LyRIng/CL2bm1/examples/cvavrexamples/lcdserialanalog/drivers/uart1a/doc/images/20180131_003055.jpg

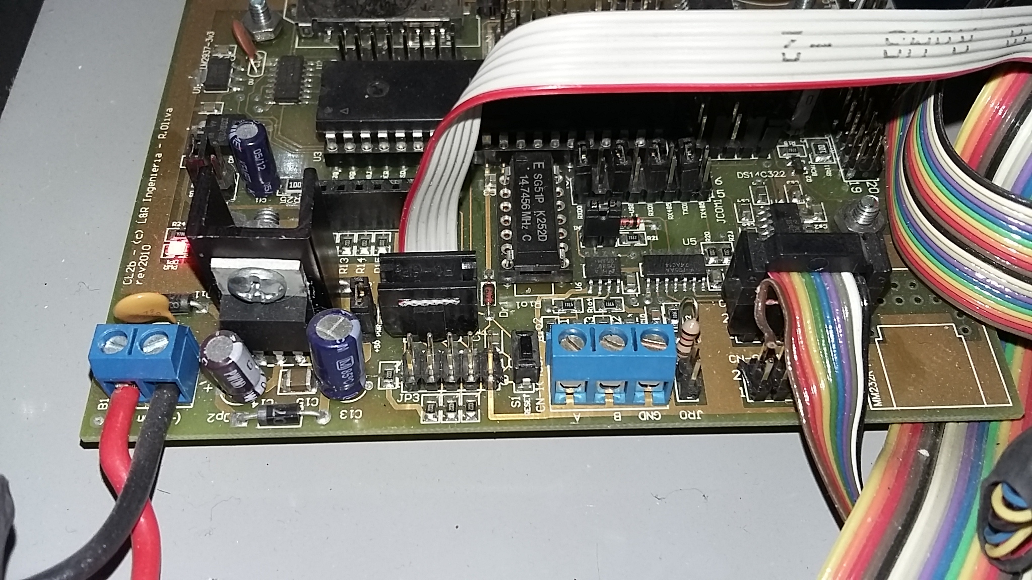
examples/cvavrexamples/lcdserialanalog/drivers/uart1a/doc/images/20180131_003055.jpg
