LyRIng/CL2bm1/examples/cvavrexamples/lcdserialanalog/drivers/uart1a/doc/Printed/Uart1_dr1_h.pdf

File: C:\cvavr328\Work3\CL2\CL2_Drivers\UART1A\TST_MENU_PRJ\inc\Uart1_dr1.h, Date: 22/02/2018, Time: 1

- 1 -

1 /***************************** C HEADER FILE *********************************
2 **
3 | ** | Project: | UART1 Driver for CL2bm1 (UART1A)
4 | ** | Filename: | Uart1_dr1.h
5 | ** | Date: | 21.02.2018
6 **
7 | ** | Modified | R.Oliva | - Include interrupt routines in C separate file (test)
8 | ** | UART1A with selectable BaudRate INIT
9 **
10 ******************************************************************************
11 **
12 **
13 ******************************************************************************
14 **
15 | ** | VERSION HISTORY:
16 | ** | ----------------
17 | ** | initial Version: | 1.0
18 | ** | Date: | 21.02.2018
19 | ** | Revised by: R.Oliva
20 | ** | Description:
21 | ** | -
22 | ** | - Newer versions see top.
23 **
24 **
25 **
26 *****************************************************************************/
27
28 #ifndef UART1_INCLUDED
29 #define UART1_INCLUDED
30
31 /****************************************************************************
32 **
33 | ** | MODULES USED
34 **
35 ****************************************************************************/ 36 #include <stdio.h>
37
38 /****************************************************************************
39 **
40 | ** | DEFINITIONS AND MACROS
41 **
42 ****************************************************************************/
43
44 #ifndef RXB8
45 #define RXB8 1
46 #endif
47
48 #ifndef TXB8
49 #define TXB8 0
50 #endif
51
52 #ifndef UPE
53 #define UPE 2
54 #endif
55
56 #ifndef DOR
57 #define DOR 3
58 #endif
59
60 #ifndef FE
61 #define FE 4
62 #endif
63
64 #ifndef UDRE
65 #define UDRE 5
66 #endif
67
68 #ifndef RXC
69 #define RXC 7
70 #endif
71
72 #ifndef FRAMING_ERROR
73 #define FRAMING_ERROR (1<<FE) 74 #endif
75
76 #ifndef PARITY_ERROR
77 #define PARITY_ERROR (1<<UPE)

- 2 -

78 #endif
79
80 #ifndef DATA_OVERRUN
81 #define DATA_OVERRUN (1<<DOR) 82 #endif
83
84 #ifndef DATA_REGISTER_EMPTY
85 #define DATA_REGISTER_EMPTY (1<<UDRE) 86 #endif
87
88 #ifndef RX_COMPLETE
89 #define RX_COMPLETE (1<<RXC) 90 #endif
91
92 // USART1 Receiver buffer
93 // New Value 22.3.2012 - works at 38400baud 94 // #define RX_BUFFER_SIZE1 8
95 #define RX_BUFFER_SIZE1 96
96
97 // USART1 Transmitter buffer 98 // 22.3.2012 New Value
99 // #define TX_BUFFER_SIZE1 8
100 #define TX_BUFFER_SIZE1 24
101
102 // UART1A - Init Baud Rate param 21.2.2018
103 | #define PBAUD_9600 | 0
104 #define PBAUD_19200 1
105 #define PBAUD_38400 2
106
107
108
109 /****************************************************************************
110 **
111 | ** | EXPORTED VARIABLES
112 | ** | declared here, but defined in .c file for global access.. 30.01.2018
113 **
114 ****************************************************************************/
115
116 extern char rx_buffer1[RX_BUFFER_SIZE1];
117
118
119 #if RX_BUFFER_SIZE1 <= 256
120 extern unsigned char rx_wr_index1,rx_rd_index1,rx_counter1; 121 #else
122 extern unsigned int rx_wr_index1,rx_rd_index1,rx_counter1; 123 #endif
124
125 // This flag is set on USART1 Receiver buffer overflow 126 extern bit rx_buffer_overflow1;
127
128 extern char tx_buffer1[TX_BUFFER_SIZE1];
129
130 #if TX_BUFFER_SIZE1 <= 256
131 extern unsigned char tx_wr_index1,tx_rd_index1,tx_counter1; 132 #else
133 extern unsigned int tx_wr_index1,tx_rd_index1,tx_counter1;
134 #endif
135
136 /****************************************************************************
137 **
138 | ** | EXPORTED FUNCTIONS
139 | ** | functions public to rest of program 30.01.2018
140 **
141 ****************************************************************************/
142
143 // Interrupt routines
144 interrupt [USART1_RXC] void usart1_rx_isr(void);
145 interrupt [USART1_TXC] void usart1_tx_isr(void);
146
147 // Alternate getchar1() defined with ISR Rx support 148 char getchar1(void);
149
150 // Alternate putchar1() defined with ISR Tx support
151 void putchar1(char c);
152
153 // USART1_Init modified (UART1A) for pbaud parameter 21.2.18 154 void USART1_Init(unsigned char pbaud);

- 3 -

155
156 #endif
157 /****************************************************************************
158 **
159 | ** | EOF
160 **
161 ****************************************************************************/
162
