LyRIng/CL2bm1/examples/cvavrexamples/lcdserialanalog/drivers/uart1a/doc/UART1A_DR1_CONSTR+TESTING FOR HEADER RULES COMPLIANCE_v21-02-2018.pdf

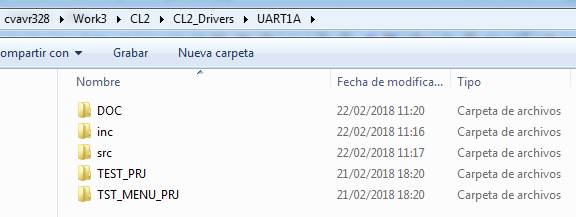
[picture p85: figure]
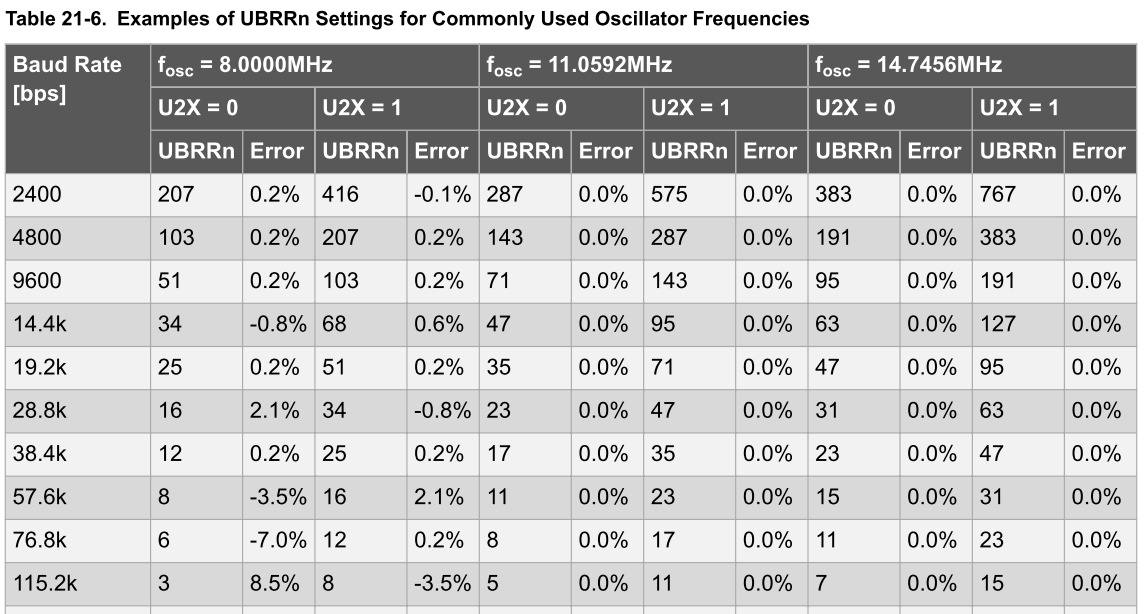
[picture p86: figure]

UART1A/ UART1_DR1 – Module CL2 / Construction + Header rules compliance testing – 20.02.2018 | Página 1

## CONSTRUCTION AND TESTING FOR HEADER RULES COMPLIANCE (Kieras, 2012)

## UART1A/UART1_DR1 MODULE on CVAVR 3 / CL2 – Rev. 21-02-2018 / R.Oliva

(UART1A / Variable Init Baud Rate, to use 4DSys Displays) Updated with test results 22-02-2018

## Reformatted – printout in PDF form

## CREATION 21-02-2018 – UART1_DR1 - (Files UART1_DR1.c / .h, formerly within mainfile) This document in: "C:\cvavr328\Work3\CL2\CL2_Drivers\UART1A\DOC\UART1A_DR1_CONSTR+TESTING FOR HEADER RULES COMPLIANCE_v21-02-2018.docx"

### A) Directory structure proposed:

B) Version Notes: 22.02.2018 This UART1A/UART1_DR1 version adds the possibility of selecting a parameter for different baud-rates within the UART1_Init(parm) function. The possible baud rates at this version are 9600 (for 4D sytems), 19200 and 38400 (used in METEO sytems). Table 1 is taken from the ATMega1284P manual, and shows selection of UBRR1 register settings for these options, which are set in the new function

### call:

void USART1_Init(uint8_t pbaud);

Table 1 - Selection of possible values from ATMega1284P manual.

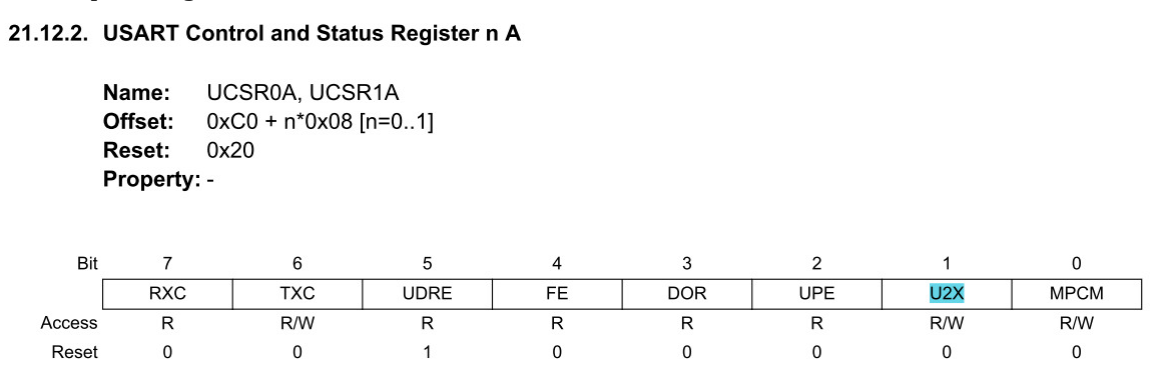
[picture p87: figure]

UART1A/ UART1_DR1 – Module CL2 / Construction + Header rules compliance testing – 20.02.2018 | Página 2

### In our case, Baud Rates will be selectable: 38400 -> u2x=0 ->UBRR=23dec = 0x17 19200 -> u2x=0 ->UBRR=47dec = 0x2F 9600 -> u2x=0 ->UBRR=95dec = 0x5F

The duplicating rate U2X bit in UCSR1A, will be set to 0 in this version. From the manual, this bit is:

C) Kieras Rule checking.

### Rule #1 – OK Groups functional operations with UART1

### Rule #2 OK – “Include guards”, used here:

#ifndef UART1_INCLUDED

#define UART1_INCLUDED

…
#endif

### Rule #3 All required declarations to use the module appear in the UART1_DR1.h file

### Rule #4 OK .h file only contains declarations, and is included by the .c file

.C FILE:
// *************************************************************
// local functions
// *************************************************************

NO LOCAL FUNCTIONS IN .C FILE

### At beginning includes its header: #include "../inc/UART1_DR1.h" (OK)

.H FILE:

### At start of .h file, these are published functions for all-prgrm access:

/************************************************************************ **
** Functions public to rest of program
**
****************************************************************************/

// Interrupt routines
interrupt [USART1_RXC] void usart1_rx_isr(void);
interrupt [USART1_TXC] void usart1_tx_isr(void);

// Alternate getchar1() defined with ISR Rx support char getchar1(void);

// Alternate putchar1() defined with ISR Tx support
void putchar1(char c);

// USART1_Init modified (UART1A) for pbaud parameter 21.2.18 void USART1_Init(uint8_t pbaud);

UART1A/ UART1_DR1 – Module CL2 / Construction + Header rules compliance testing – 20.02.2018 | Página 3

// New Functions defined in .C file: /**************************************************************************** **
** Initializes the UART1 - version UART1A with parameter 21.2.18
**
** Parameters: uint8_t pbaud, can take values:
** #define PBAUD_9600 0
** #define PBAUD_19200 1
** #define PBAUD_38400 2
** Then for each option, considering CLK=14.7456E06 Hz ** 38400 -> u2x=0 ->UBRR=23dec = 0x17
** 19200 -> u2x=0 ->UBRR=47dec = 0x2F
** 9600 -> u2x=0 ->UBRR=95dec = 0x5F
**
** Returns: NONE
**
****************************************************************************/ // USART1_Init modified for pbaud parameter
void USART1_Init(uint8_t pbaud)
{
| switch(pbaud){ case PBAUD_9600: // USART1 initialization 9600 baud // Communication Parameters: 8 Data, 1 Stop, No Parity // USART1 Receiver: On // USART1 Transmitter: On // USART1 Mode: Asynchronous // USART1 Baud Rate: 9600 UCSR1A=0x00; UCSR1B=0xD8; UCSR1C=0x06; UBRR1H=0x00; UBRR1L=0x5F; // ==95 dec for 9600, U2X=0 break; case PBAUD_19200: // USART1 initialization 19200 // Communication Parameters: 8 Data, 1 Stop, No Parity // USART1 Receiver: On // USART1 Transmitter: On // USART1 Mode: Asynchronous // USART1 Baud Rate: 19200 UCSR1A=0x00; UCSR1B=0xD8; UCSR1C=0x06; UBRR1H=0x00; UBRR1L=0x2F; // ==47 dec for 19200, U2X=0 break; case PBAUD_38400: // USART1 initialization 38400 baud (PWRC2 - V22.3.2012) // Communication Parameters: 8 Data, 1 Stop, No Parity // USART1 Receiver: On // USART1 Transmitter: On // USART1 Mode: Asynchronous // USART1 Baud Rate: 38400 UCSR1A=0x00; UCSR1B=0xD8; UCSR1C=0x06; UBRR1H=0x00; UBRR1L=0x17; // ==23 dec for 38400, U2X=0 break; default: printf("\n\r Parametro COM1 Incorrecto! (9600, 19200 o 38400)"); break; }

}

// Slightly modified RX_ISR: /***************************************************************************** **
** USART1 Receiver interrupt service routine
** Buffer Size 256 not considered..30.1.18 *****************************************************************************/

interrupt [USART1_RXC] void usart1_rx_isr(void)
{
char status,data;
status=UCSR1A;
data=UDR1;

UART1A/ UART1_DR1 – Module CL2 / Construction + Header rules compliance testing – 20.02.2018 | Página 4
if ((status & (FRAMING_ERROR | PARITY_ERROR | DATA_OVERRUN))==0)
{
rx_buffer1[rx_wr_index1++]=data;
// #if RX_BUFFER_SIZE1 == 256
// special case for receiver buffer size=256 // if (++rx_counter1 == 0)
// {
// #else
if (rx_wr_index1 == RX_BUFFER_SIZE1) rx_wr_index1=0; if (++rx_counter1 == RX_BUFFER_SIZE1)
| {
| rx_counter1=0;
//#endif
| rx_buffer_overflow1=1;
| }
}
}

Rule #5 OK Globally used variables are declared as extern in .h file, and defined in .c file:
/ /****************************************************************************
**
** | EXPORTED VARIABLES
** | declared here, but defined in .c file for global access.. 30.01.2018
**
****************************************************************************/

extern char rx_buffer1[RX_BUFFER_SIZE1];

#if RX_BUFFER_SIZE1 <= 256

extern unsigned char rx_wr_index1,rx_rd_index1,rx_counter1; #else
extern unsigned int rx_wr_index1,rx_rd_index1,rx_counter1; #endif

// This flag is set on USART1 Receiver buffer overflow extern bit rx_buffer_overflow1;

extern char tx_buffer1[TX_BUFFER_SIZE1];

#if TX_BUFFER_SIZE1 <= 256

extern unsigned char tx_wr_index1,tx_rd_index1,tx_counter1; #else
extern unsigned int tx_wr_index1,tx_rd_index1,tx_counter1; #endif

### These VARIABLES are memory assigned in the .c file as follows:

/***************************************************************************** **
** UART1 Global Variables declared in uart1_dr1.h
** MEMORY IS ASSIGNED
** HERE FOLLOWING RULE #5
**
*****************************************************************************/

char rx_buffer1[RX_BUFFER_SIZE1];

#if RX_BUFFER_SIZE1 <= 256

unsigned char rx_wr_index1,rx_rd_index1,rx_counter1; #else
unsigned int rx_wr_index1,rx_rd_index1,rx_counter1; #endif

// This flag is set on USART1 Receiver buffer overflow bit rx_buffer_overflow1;

char tx_buffer1[TX_BUFFER_SIZE1];

#if TX_BUFFER_SIZE1 <= 256

unsigned char tx_wr_index1,tx_rd_index1,tx_counter1; #else
unsigned int tx_wr_index1,tx_rd_index1,tx_counter1; #endif

### Rule #6 Internal declarations kept out of .h module Ok

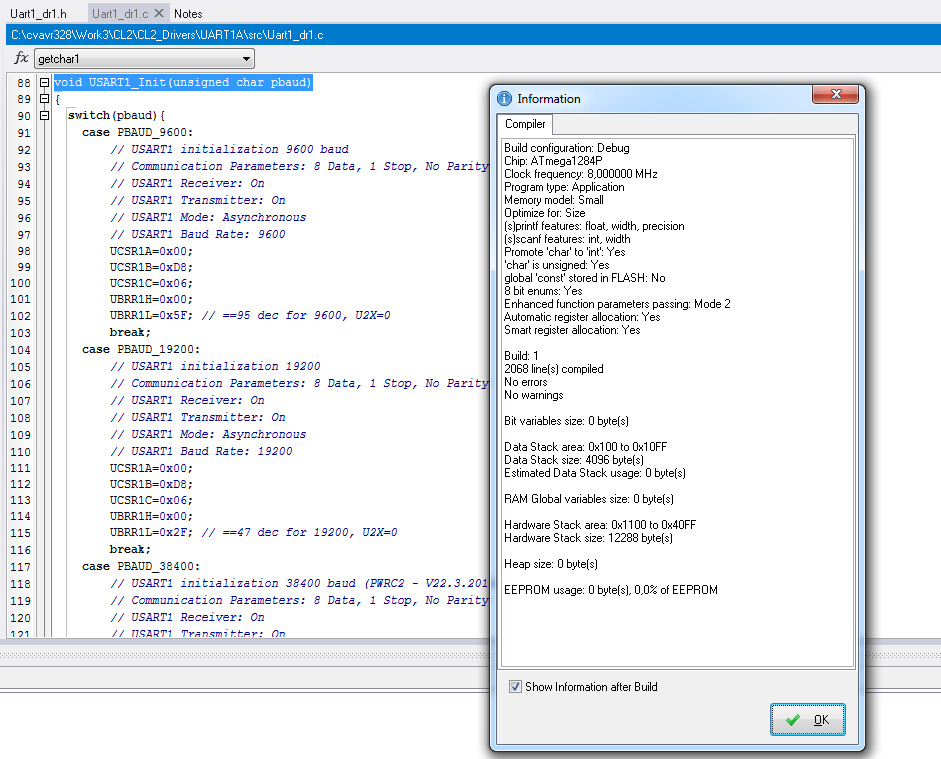
[picture p88: figure]

UART1A/ UART1_DR1 – Module CL2 / Construction + Header rules compliance testing – 20.02.2018 | Página 5

Rule #7,8 Not Applicable, since no external .h functions are required for this module.

### Rule #9 Self compilation :

In CVAVR 3 we need to make a Test_Uart1Dr.prj, including only the file uart1_dr1.c, which at the start executes: #include "../inc/ uart1_dr1.h" – see if it compiles correctly by itself.

PRJ file should be confined it to:
C:\cvavr328\Work3\CL2\CL2_Drivers\. It creates a test_dr.c empty file, which is not used at this stage..

Rule #10 OK: UART1_DR1.c includes at beginning the file UART1_DR1.h, other files not applicable, since no external .h functions are required for this module.

Rule #11 OK no .c files #included.

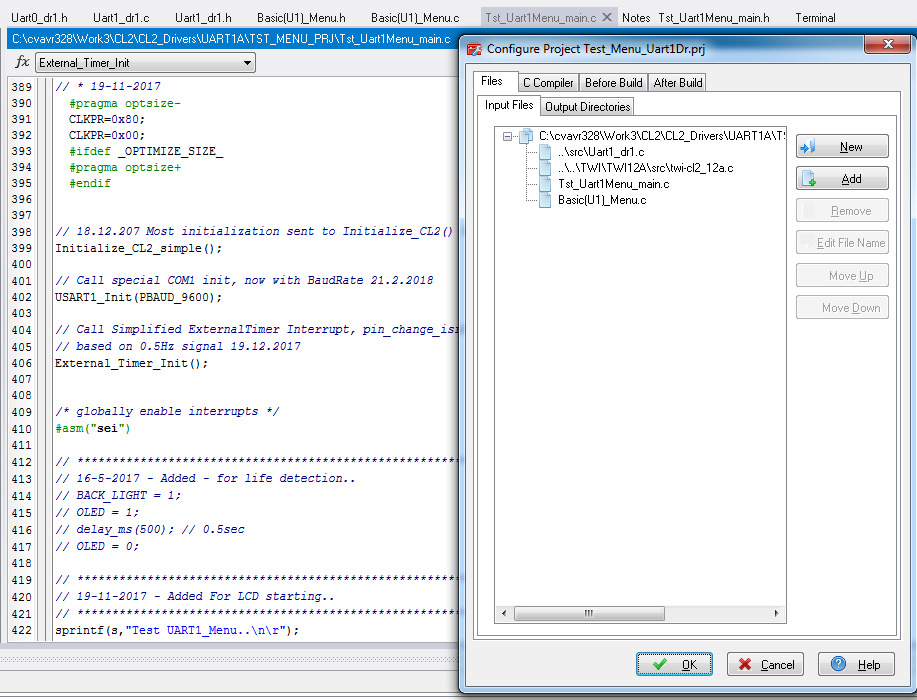
[picture p89: figure]

UART1A/ UART1_DR1 – Module CL2 / Construction + Header rules compliance testing – 20.02.2018 | Página 6

## TESTING:

A) 22.02.2018 NOW TEST NEW UART1A/UART1_DR1 WITH TST_MENU_UART1.PRJ,

### C:\cvavr328\Work3\CL2\CL2_Drivers\UART1A\TST_FUNC_PRJ\Test_Menu_Uart1Dr.prj

This Project copies (A) and includes a simple Menu System borrowed from PWRC2, to test the reading & writing via UART1 drivers, specially at 9600 baud (required by 4DSystems Displays).

### SOURCE CODE For Menu on UART1 / UART1A (see project)

### We set up terminal for testing, 9600,n1,8,1 – works ok in transmission & reception..:

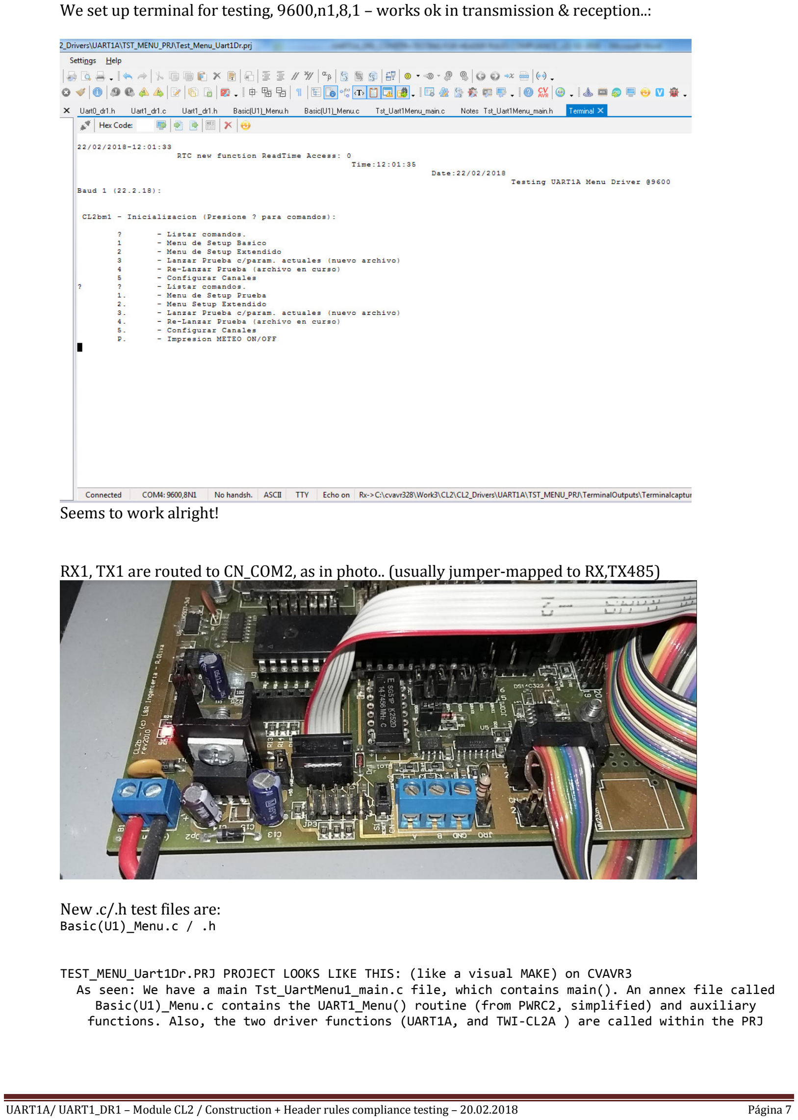
[picture p90: page 7]

UART1A/ UART1_DR1 – Module CL2 / Construction + Header rules compliance testing – 20.02.2018 | Página 7

### Seems to work alright!

### RX1, TX1 are routed to CN_COM2, as in photo.. (usually jumper-mapped to RX,TX485)

### New .c/.h test files are:

Basic(U1)_Menu.c / .h

TEST_MENU_Uart1Dr.PRJ PROJECT LOOKS LIKE THIS: (like a visual MAKE) on CVAVR3
As seen: We have a main Tst_UartMenu1_main.c file, which contains main(). An annex file called Basic(U1)_Menu.c contains the UART1_Menu() routine (from PWRC2, simplified) and auxiliary functions. Also, the two driver functions (UART1A, and TWI-CL2A ) are called within the PRJ


UART1A/ UART1_DR1 – Module CL2 / Construction + Header rules compliance testing – 20.02.2018 | Página 8

Project of new UART1_dr1.c/.h Menu testing..

APPENDIX: As usual, we use the following programming settings:
