LyRIng/CL2bm1/schem/V5g_CL2bProto_17-2-2010_Schematic Prints.pdf

# CL2B Proto Board - (c) 2009 / LyR Ingenieria COMM CIRCUITS

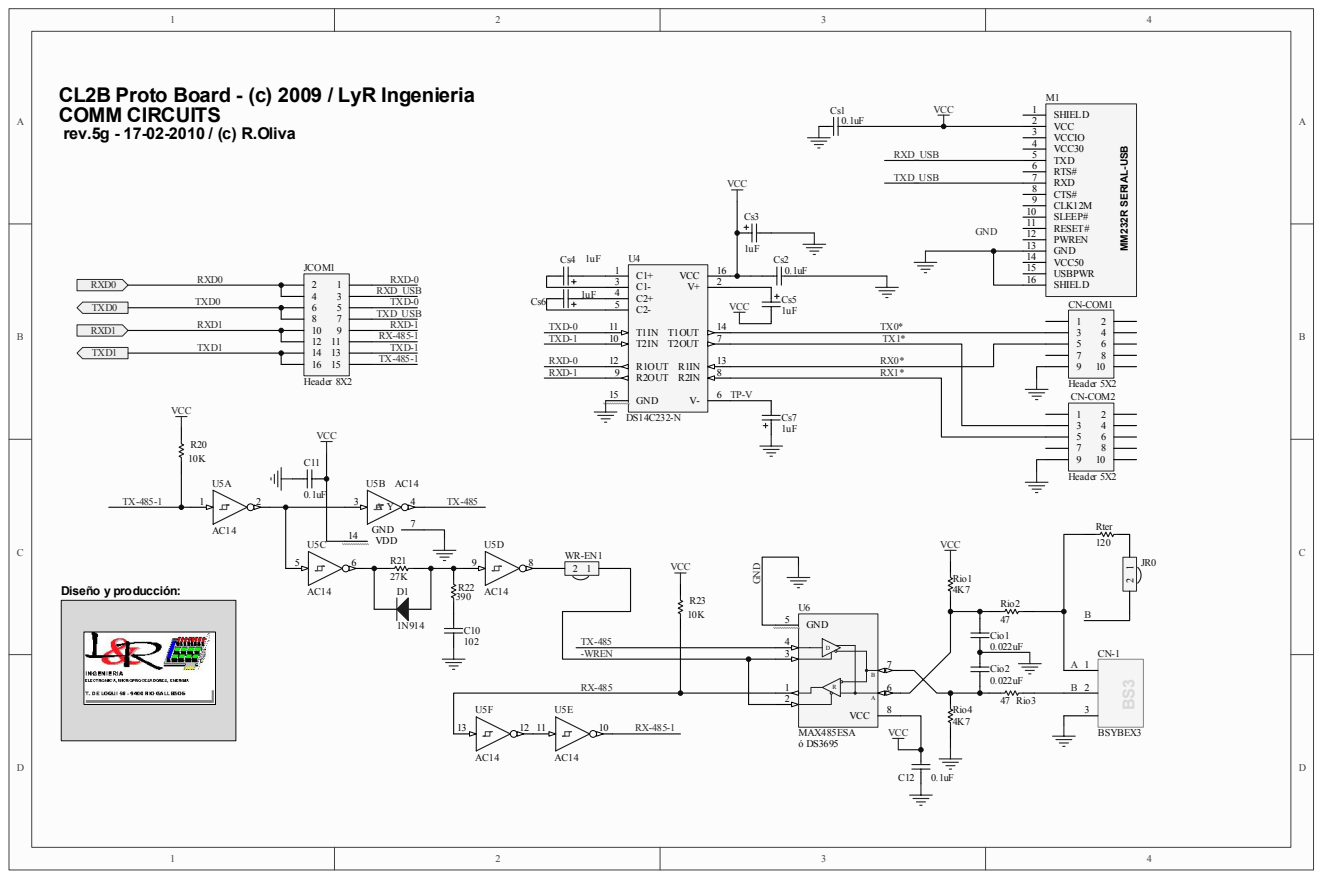
[picture p94: page 1]

# CL2B Proto Board - (c) 2009 / LyR Ingenieria

# CPU+Peripheral

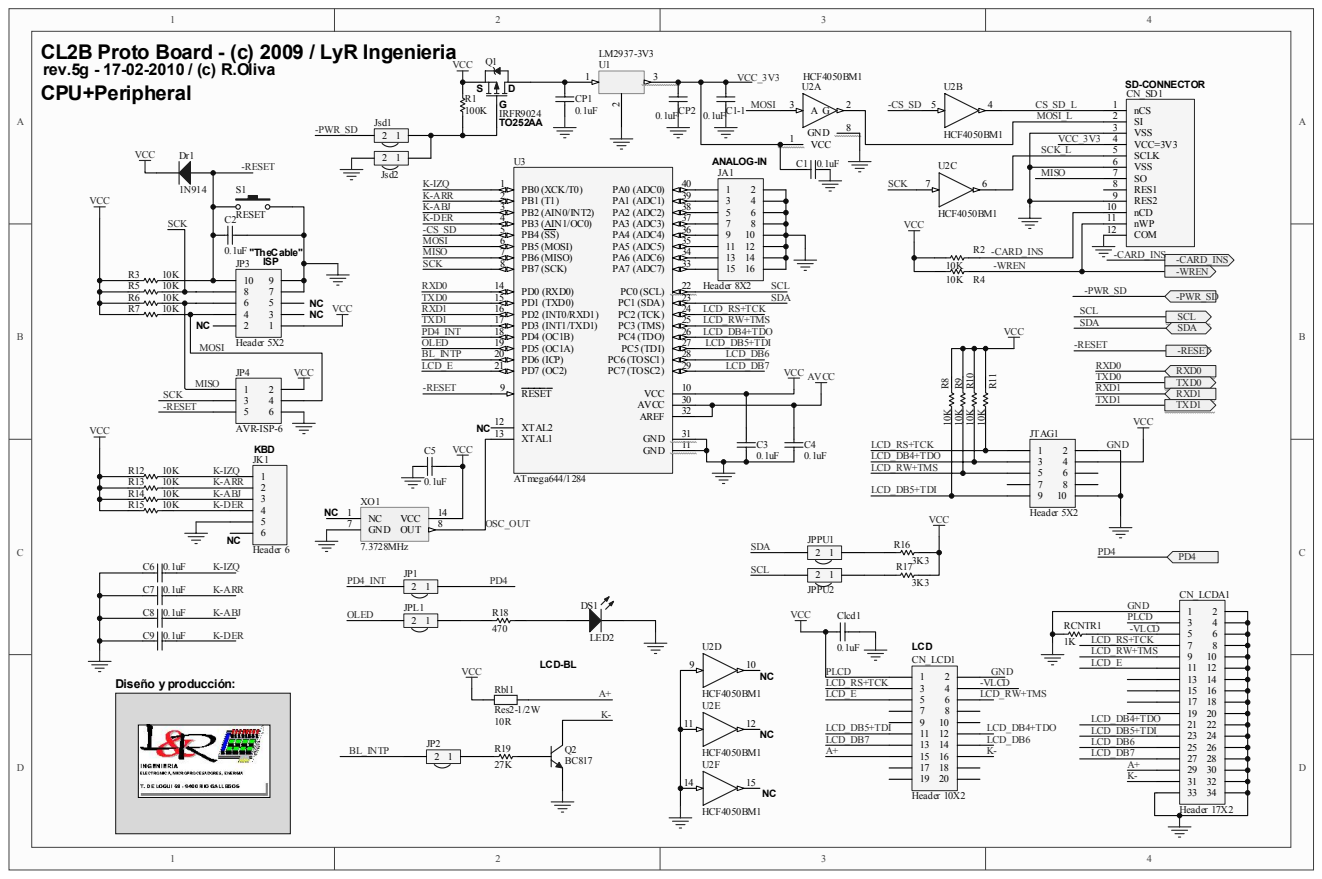
[picture p95: page 2]

Q1 VCC VCC Dr1 1N914 VCC | VCC_3V3 HCF4050BM1 | CS_SD_L MOSI_L

# CL2B Proto Board - (c) 2009 / LyR Ingenieria I2C Peripherals

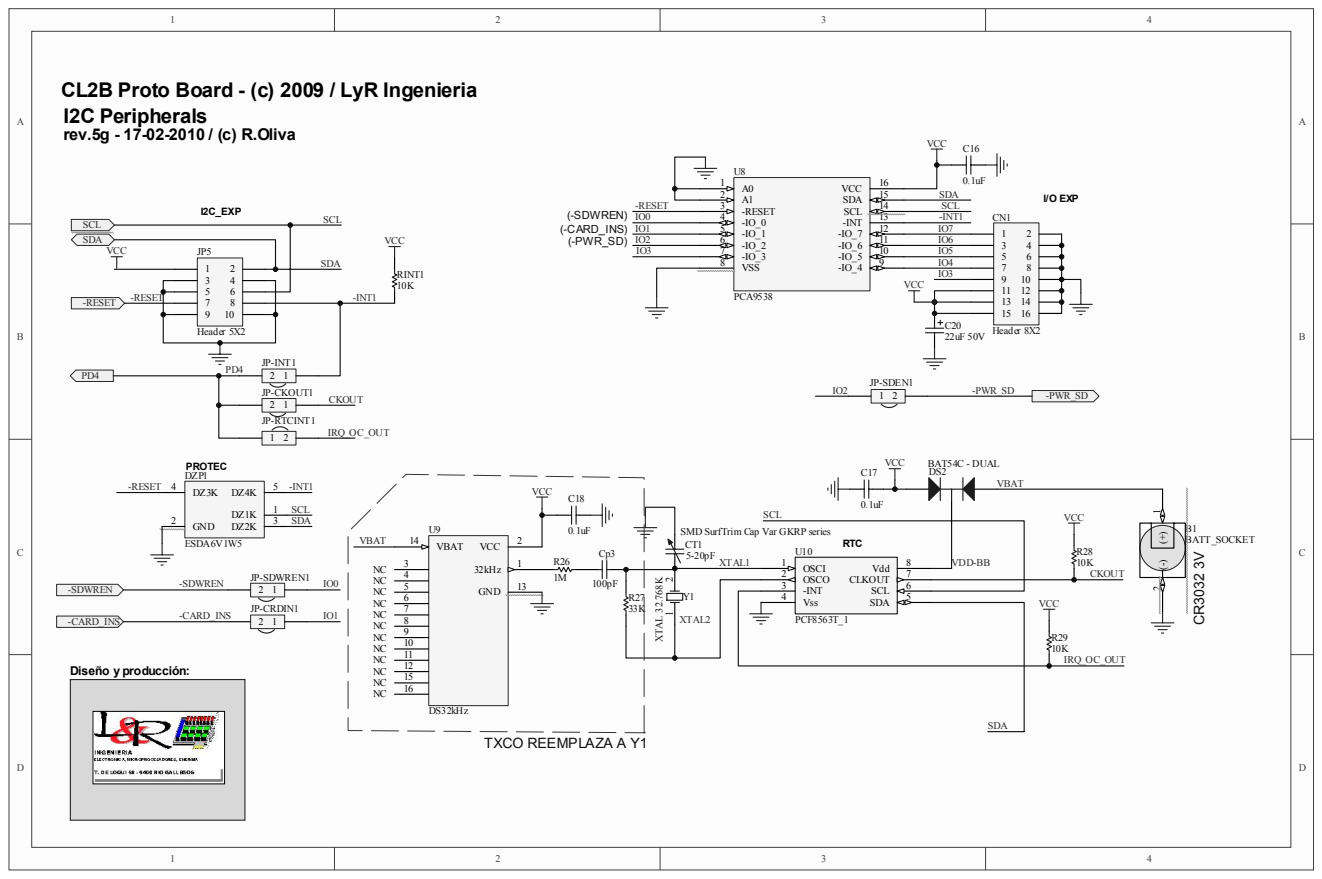
[picture p96: page 3]

# CL2B Proto-Board - (c) 2009 / LyR Ingenieria Diagrama Principal

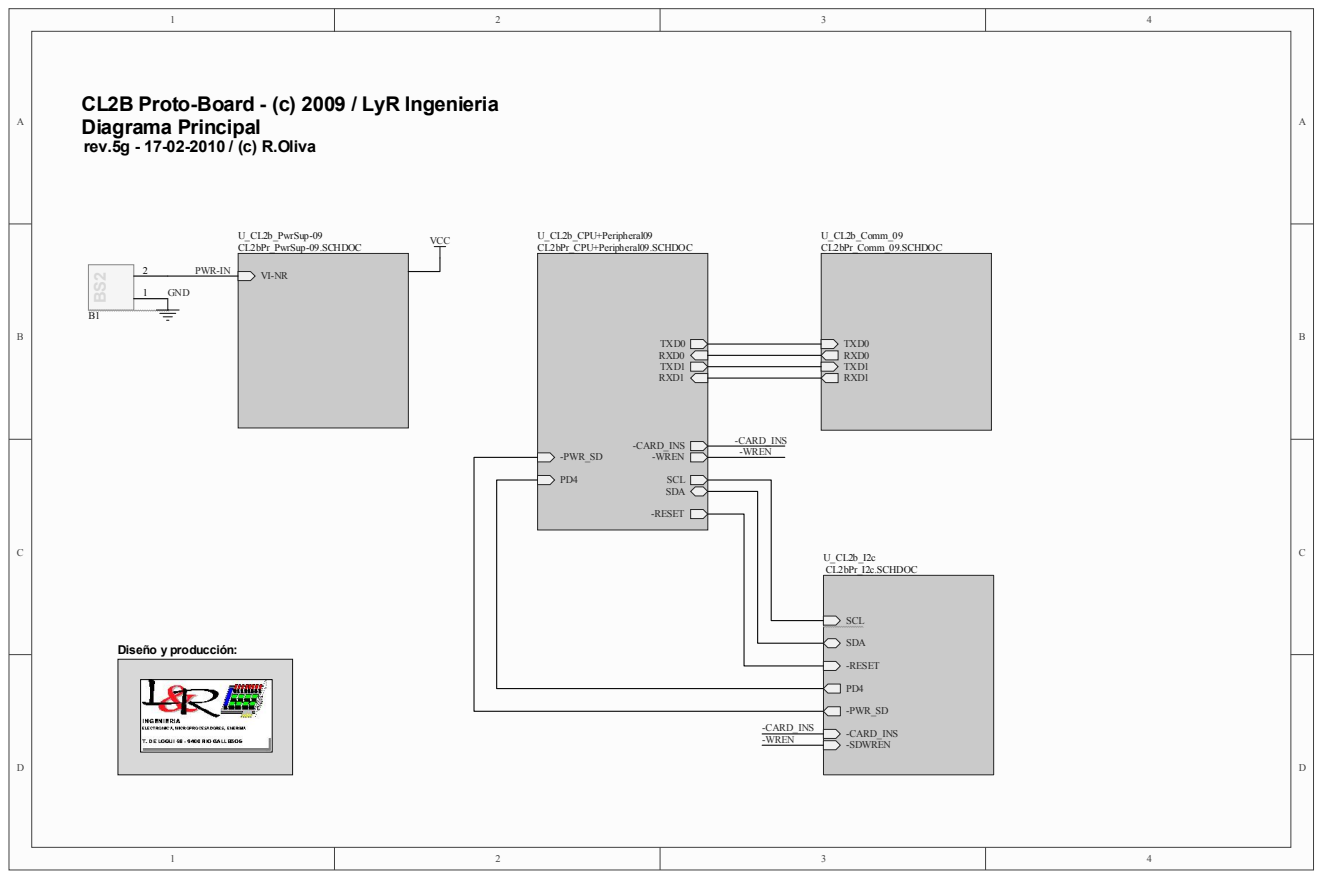
[picture p97: page 4]
Diseño y producción:; -RESET; SCL SDA; TXD0; TXD1; RXD0; RXD1; -CARD_INS -WREN; -PWR_SD; U_CL2b_CPU+Peripheral09 CL2bPr_CPU+Peripheral09.SCHDOC; U_CL2b_Comm_09 CL2bPr_Comm_09.SCHDOC; U_CL2b_PwrSup-09 CL2bPr_PwrSup-09.SCHDOC; GND; PWR-IN; SCL; SDA; -CARD_INS -SDWREN; U_CL2b_I2c CL2bPr_I2c.SCHDOC; -WREN; -CARD_INS; VCC; rev.5g - 17-02-2010 / (c) R.Oliva

A | CL2-B ProtoBoard - (c) 2009 / LyR Ingenieria | A
| Power Supply

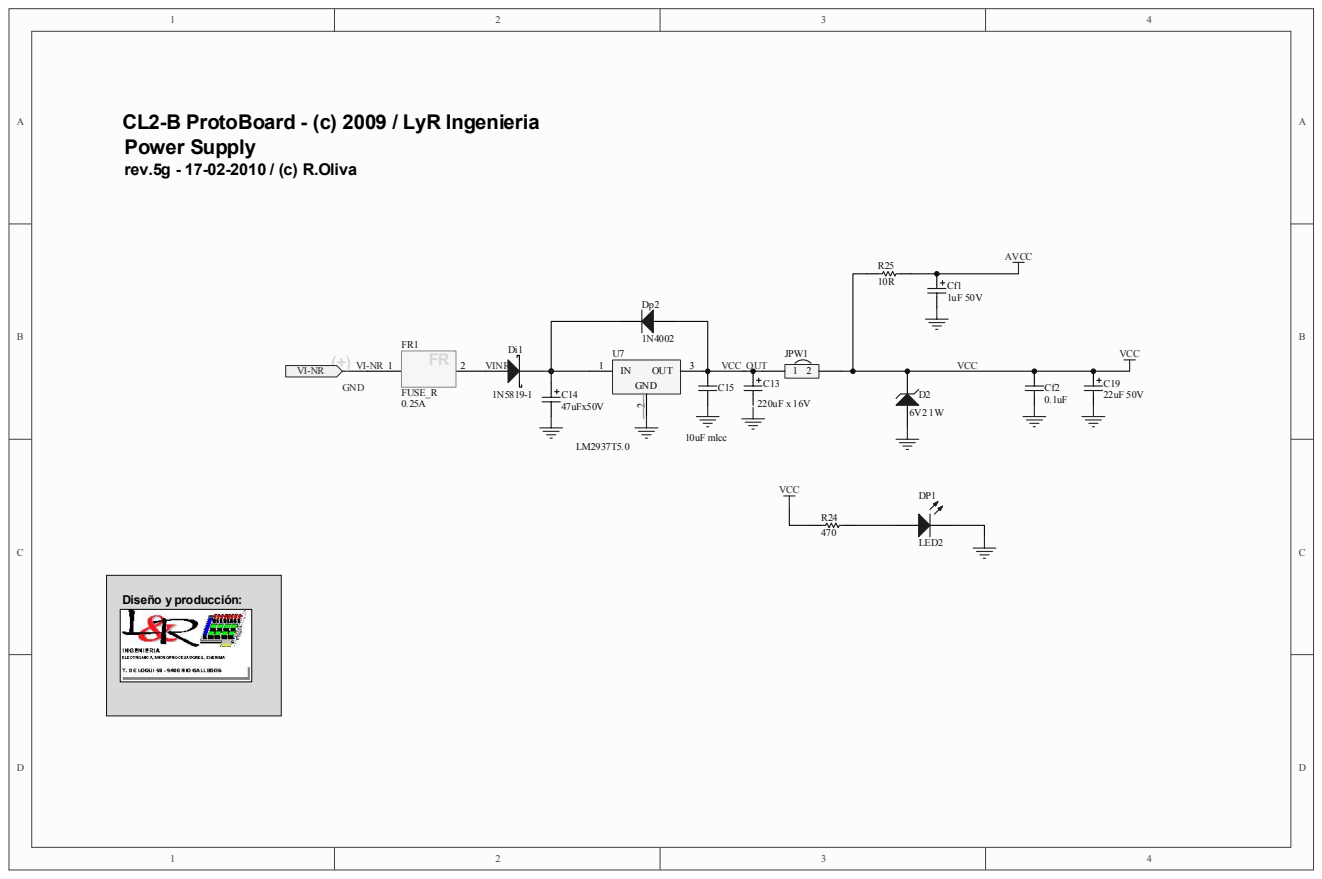
[picture p98: page 5]
