LyRIng/CL2bm1/(commit log)

2022-03-10 First commit on CL2bm1 CPU board repo by LyRIng
2022-03-10 Corrected Readme link on CL2bm1 CPU board repo by LyRIng
2022-03-16 Added final version of CVAVR examples and related documentation
    [ADC_tst.cfg, ADC_tst2.cfg, Test_Uart0Dr.cfg, Test_Uart1Dr.cfg, blinkled1.cfg, display_tst.cfg, lcdserialanalog1.cfg, serialanalog1.cfg]
